JorjBauer/profile-emulator/fpga/hw-r2/profile-drive/placement-r2.png

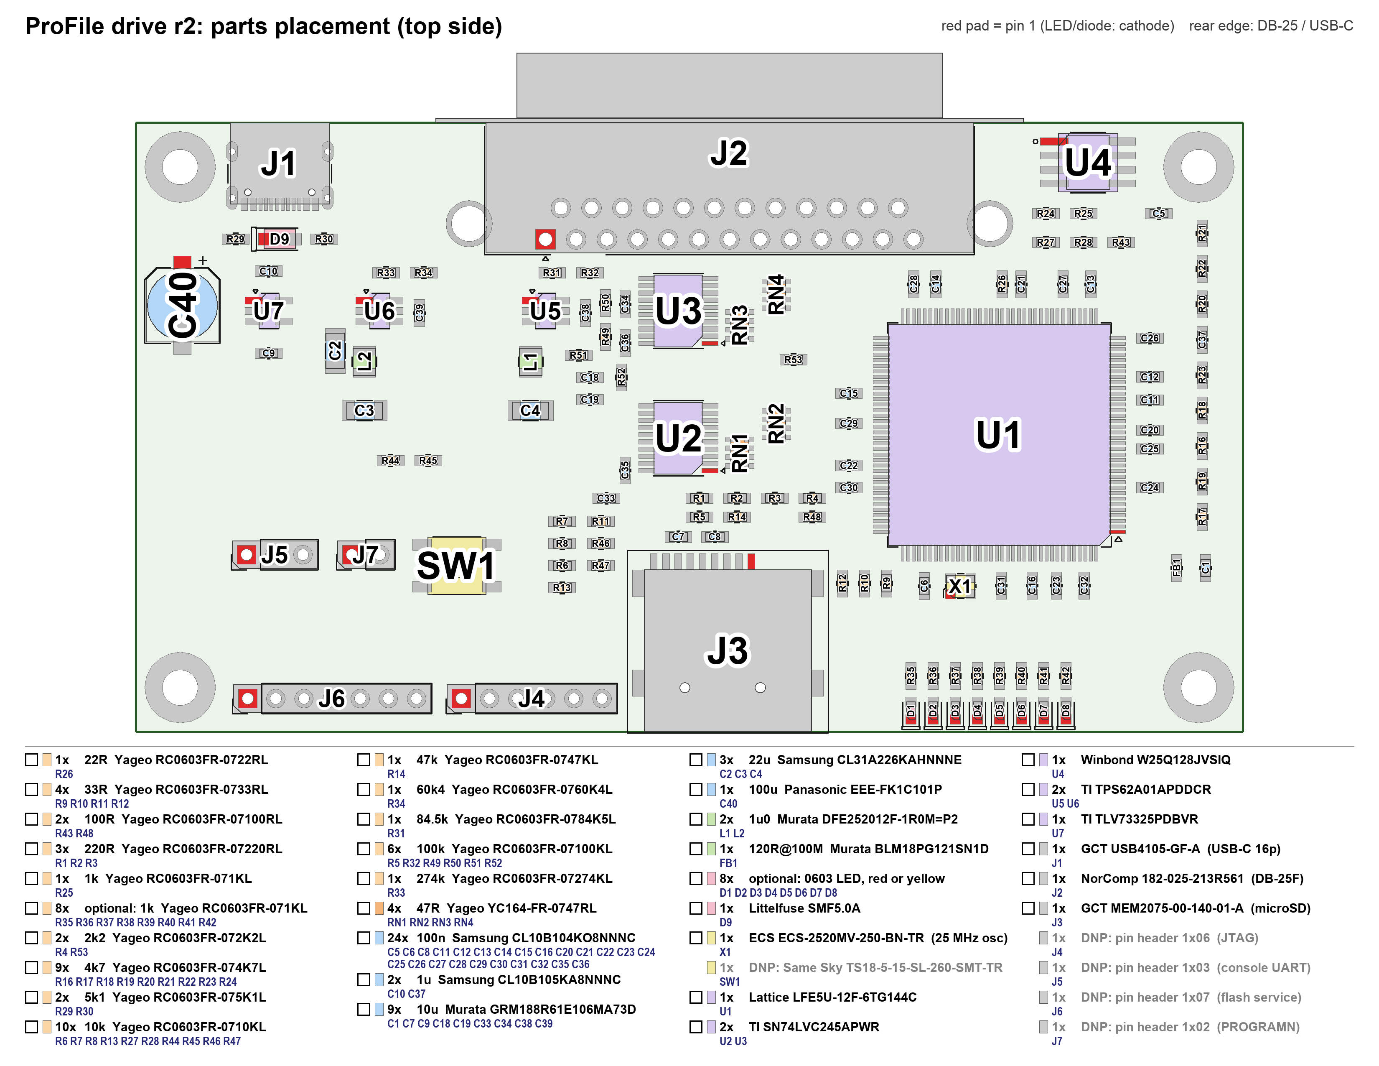
fpga/hw-r2/profile-drive/placement-r2.png
