JorjBauer/profile-emulator/fpga/hw-r2/profile-drive/profile-drive-r2-bom-jlcpcb.csv

Comment | Designator | Footprint | Manufacturer Part | LCSC Part #
10u | C1,C7,C9,C18,C19,C33,C34,C38,C39 | C_0603_1608Metric | Murata GRM188R61E106MA73D | C91606
22u | C2,C3,C4 | C_1206_3216Metric | Samsung CL31A226KAHNNNE | C12891
100n | C5,C6,C8,C11,C12,C13,C14,C15,C16,C20,C21,C22,C23,C24,C25,C26,C27,C28,C29,C30,C31,C32,C35,C36 | C_0603_1608Metric | Samsung CL10B104KO8NNNC | C66501
1u | C10,C37 | C_0603_1608Metric | Samsung CL10B105KA8NNNC | C29936
100u | C40 | CP_Elec_6.3x5.8 | Panasonic EEE-FK1C101P | C128532
LED red 0603 | D1,D2,D3,D4,D5,D6,D7,D8 | LED_0603_1608Metric | Hubei KENTO KT-0603R | C2286
SMF5.0A | D9 | D_SOD-123F | Littelfuse SMF5.0A | C151296
120R@100M | FB1 | L_0603_1608Metric | Murata BLM18PG121SN1D | C14709
USB-C 16p | J1 | USB_C_Receptacle_GCT_USB4105-xx-A_16P_TopMnt_Horizontal | GCT USB4105-GF-A | C3020560
NorComp 182-025-213R561 | J2 | DSUB-25_Female_Horizontal_NorComp_182-025-213R561 | NorComp 182-025-213R561 | C17257261
microSD MEM2075 | J3 | microSD_GCT_MEM2075 | GCT MEM2075-00-140-01-A | C3029735
1u0 | L1,L2 | L_Murata_DFE252012F | Murata DFE252012F-1R0M=P2 | C435392
220R | R1,R2,R3 | R_0603_1608Metric | Yageo RC0603FR-07220RL | C107696
2k2 | R4,R53 | R_0603_1608Metric | Yageo RC0603FR-072K2L | C114662
100k | R5,R32,R49,R50,R51,R52 | R_0603_1608Metric | Yageo RC0603FR-07100KL | C14675
10k | R6,R7,R8,R13,R27,R28,R44,R45,R46,R47 | R_0603_1608Metric | Yageo RC0603FR-0710KL | C98220
33R | R9,R10,R11,R12 | R_0603_1608Metric | Yageo RC0603FR-0733RL | C108661
47k | R14 | R_0603_1608Metric | Yageo RC0603FR-0747KL | C105579
4k7 | R16,R17,R18,R19,R20,R21,R22,R23,R24 | R_0603_1608Metric | Yageo RC0603FR-074K7L | C99782
1k | R25,R35,R36,R37,R38,R39,R40,R41,R42 | R_0603_1608Metric | Yageo RC0603FR-071KL | C22548
22R | R26 | R_0603_1608Metric | Yageo RC0603FR-0722RL | C107701
5k1 | R29,R30 | R_0603_1608Metric | Yageo RC0603FR-075K1L | C105580
84.5k | R31 | R_0603_1608Metric | Yageo RC0603FR-0784K5L | C326920
274k | R33 | R_0603_1608Metric | Yageo RC0603FR-07274KL | C482818
60k4 | R34 | R_0603_1608Metric | Yageo RC0603FR-0760K4L | C165742
100R | R43,R48 | R_0603_1608Metric | Yageo RC0603FR-07100RL | C105588
47R | RN1,RN2,RN3,RN4 | R_Array_Convex_4x0603_Yageo_YC164 | Yageo YC164-FR-0747RL | C606217
LFE5U-12F-6TG144C | U1 | TQFP-144_20x20mm_P0.5mm | Lattice LFE5U-12F-6TG144C | C19979181
74LVC245A | U2,U3 | TSSOP-20_4.4x6.5mm_P0.65mm | TI SN74LVC245APWR | C7848
W25Q128JVSIQ | U4 | SOIC-8_Dual_150-208mil_P1.27mm | Winbond W25Q128JVSIQ | C97521
TPS62A01A | U5,U6 | SOT-23-6_Handsoldering | TI TPS62A01APDDCR | C41730179
TLV73325PDBV 2V5 | U7 | SOT-23-5_HandSoldering | TI TLV73325PDBVR | C882825
25MHz XO 2520 3V3 | X1 | Oscillator_SMD_ECS_2520MV-xxx-xx-4Pin_2.5x2.0mm | ECS ECS-2520MV-250-BN-TR | C405463
