JorjBauer/profile-emulator/fpga/hw-r2/enclosure/base.stl

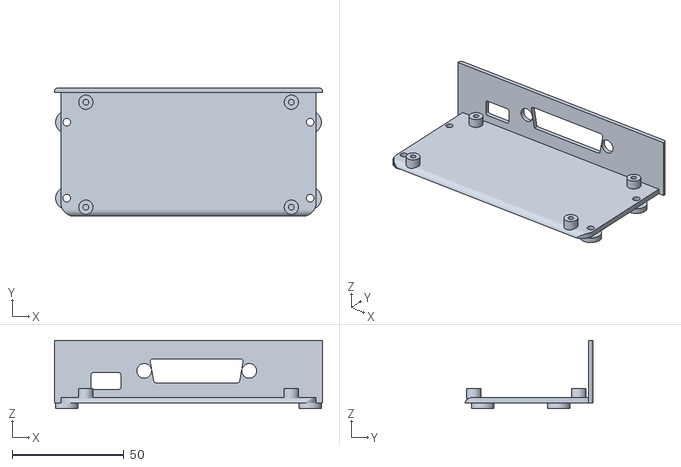
[picture p4: CAD file, 2026-10-11]
fpga/hw-r2/enclosure/base.stl
120.0 x 57.4 x 30.5
