JorjBauer/profile-emulator/fpga/hw-r2/enclosure/cover.stl

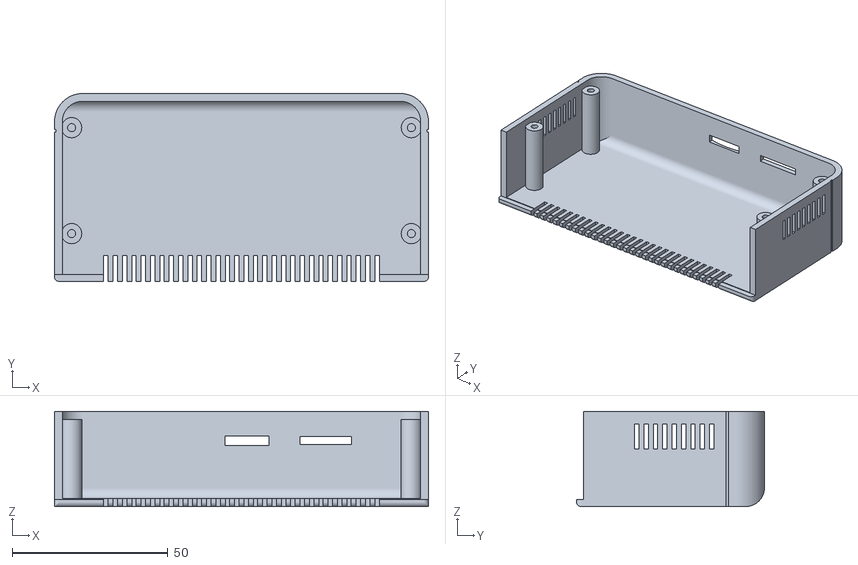
[picture p5: CAD file, 2026-10-10]
fpga/hw-r2/enclosure/cover.stl
120.0 x 60.3 x 30.5
