JorjBauer/profile-emulator/fpga/hw-r2/profile-drive/assembly-r2.pdf

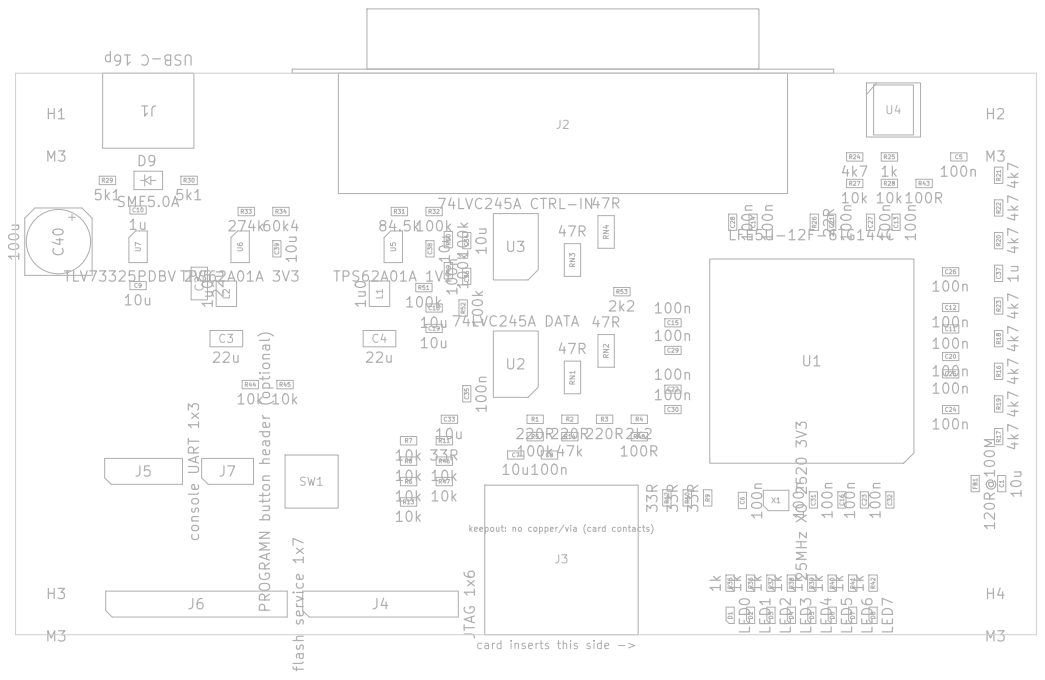
[picture p6: page 1]

keepout: no copper/via (card contacts) J3 10u

File: profile-drive.kicad_pcb
Title: ProFile drive replacement: LFE5U-12F TQFP144, standalone

Size: A4 | Rev: r2
KiCad E.D.A. 10.0.4 | Id: 1/1
