JorjBauer/profile-emulator/fpga/hw-r2/profile-drive/profile-drive.kicad_pcb

## KiCad design fpga/hw-r2/profile-drive/profile-drive.kicad_pcb (2026-10-25)

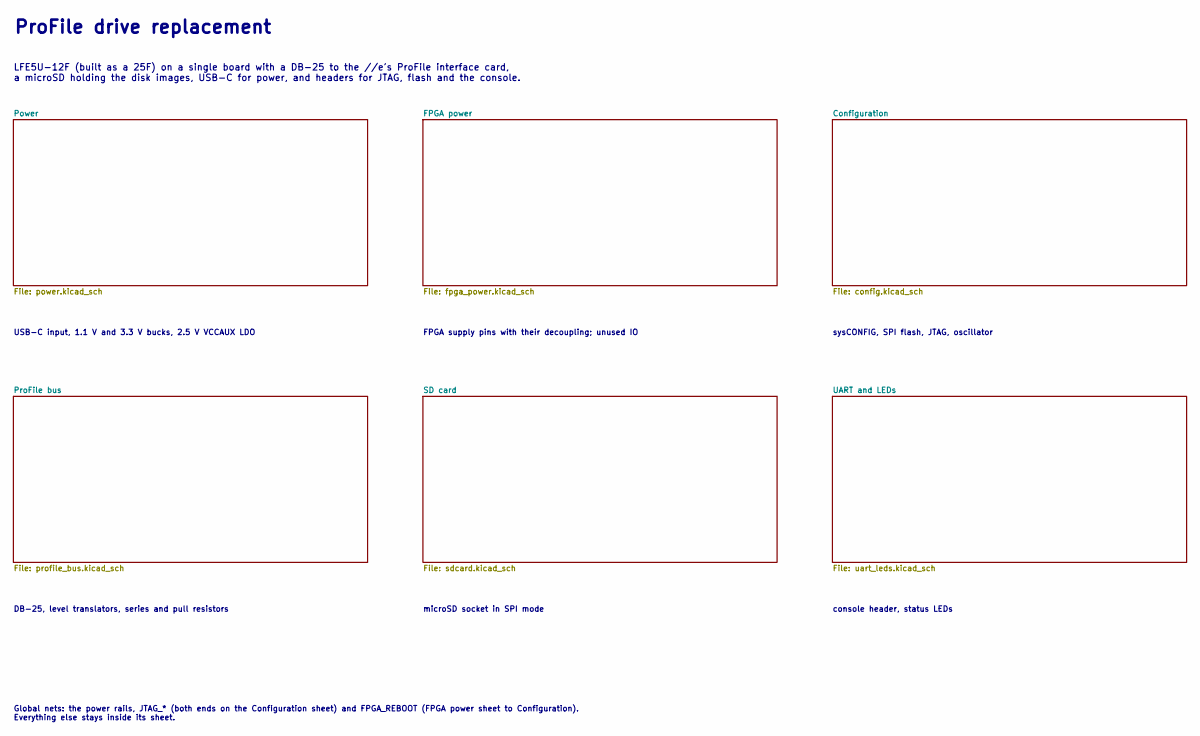
[picture p7: schematic profile-drive.kicad_sch, ProFile drive replacement: LFE5U-12F TQFP144, standalone]

Notes on the sheet:
ProFile drive replacement
LFE5U-12F (built as a 25F) on a single board with a DB-25 to the //e's ProFile interface card, a microSD holding the disk images, USB-C for power, and headers for JTAG, flash and the console.
USB-C input, 1.1 V and 3.3 V bucks, 2.5 V VCCAUX LDO
FPGA supply pins with their decoupling; unused IO
sysCONFIG, SPI flash, JTAG, oscillator
DB-25, level translators, series and pull resistors
microSD socket in SPI mode
console header, status LEDs
Global nets: the power rails, JTAG_* (both ends on the Configuration sheet) and FPGA_REBOOT (FPGA power sheet to Configuration). Everything else stays inside its sheet.

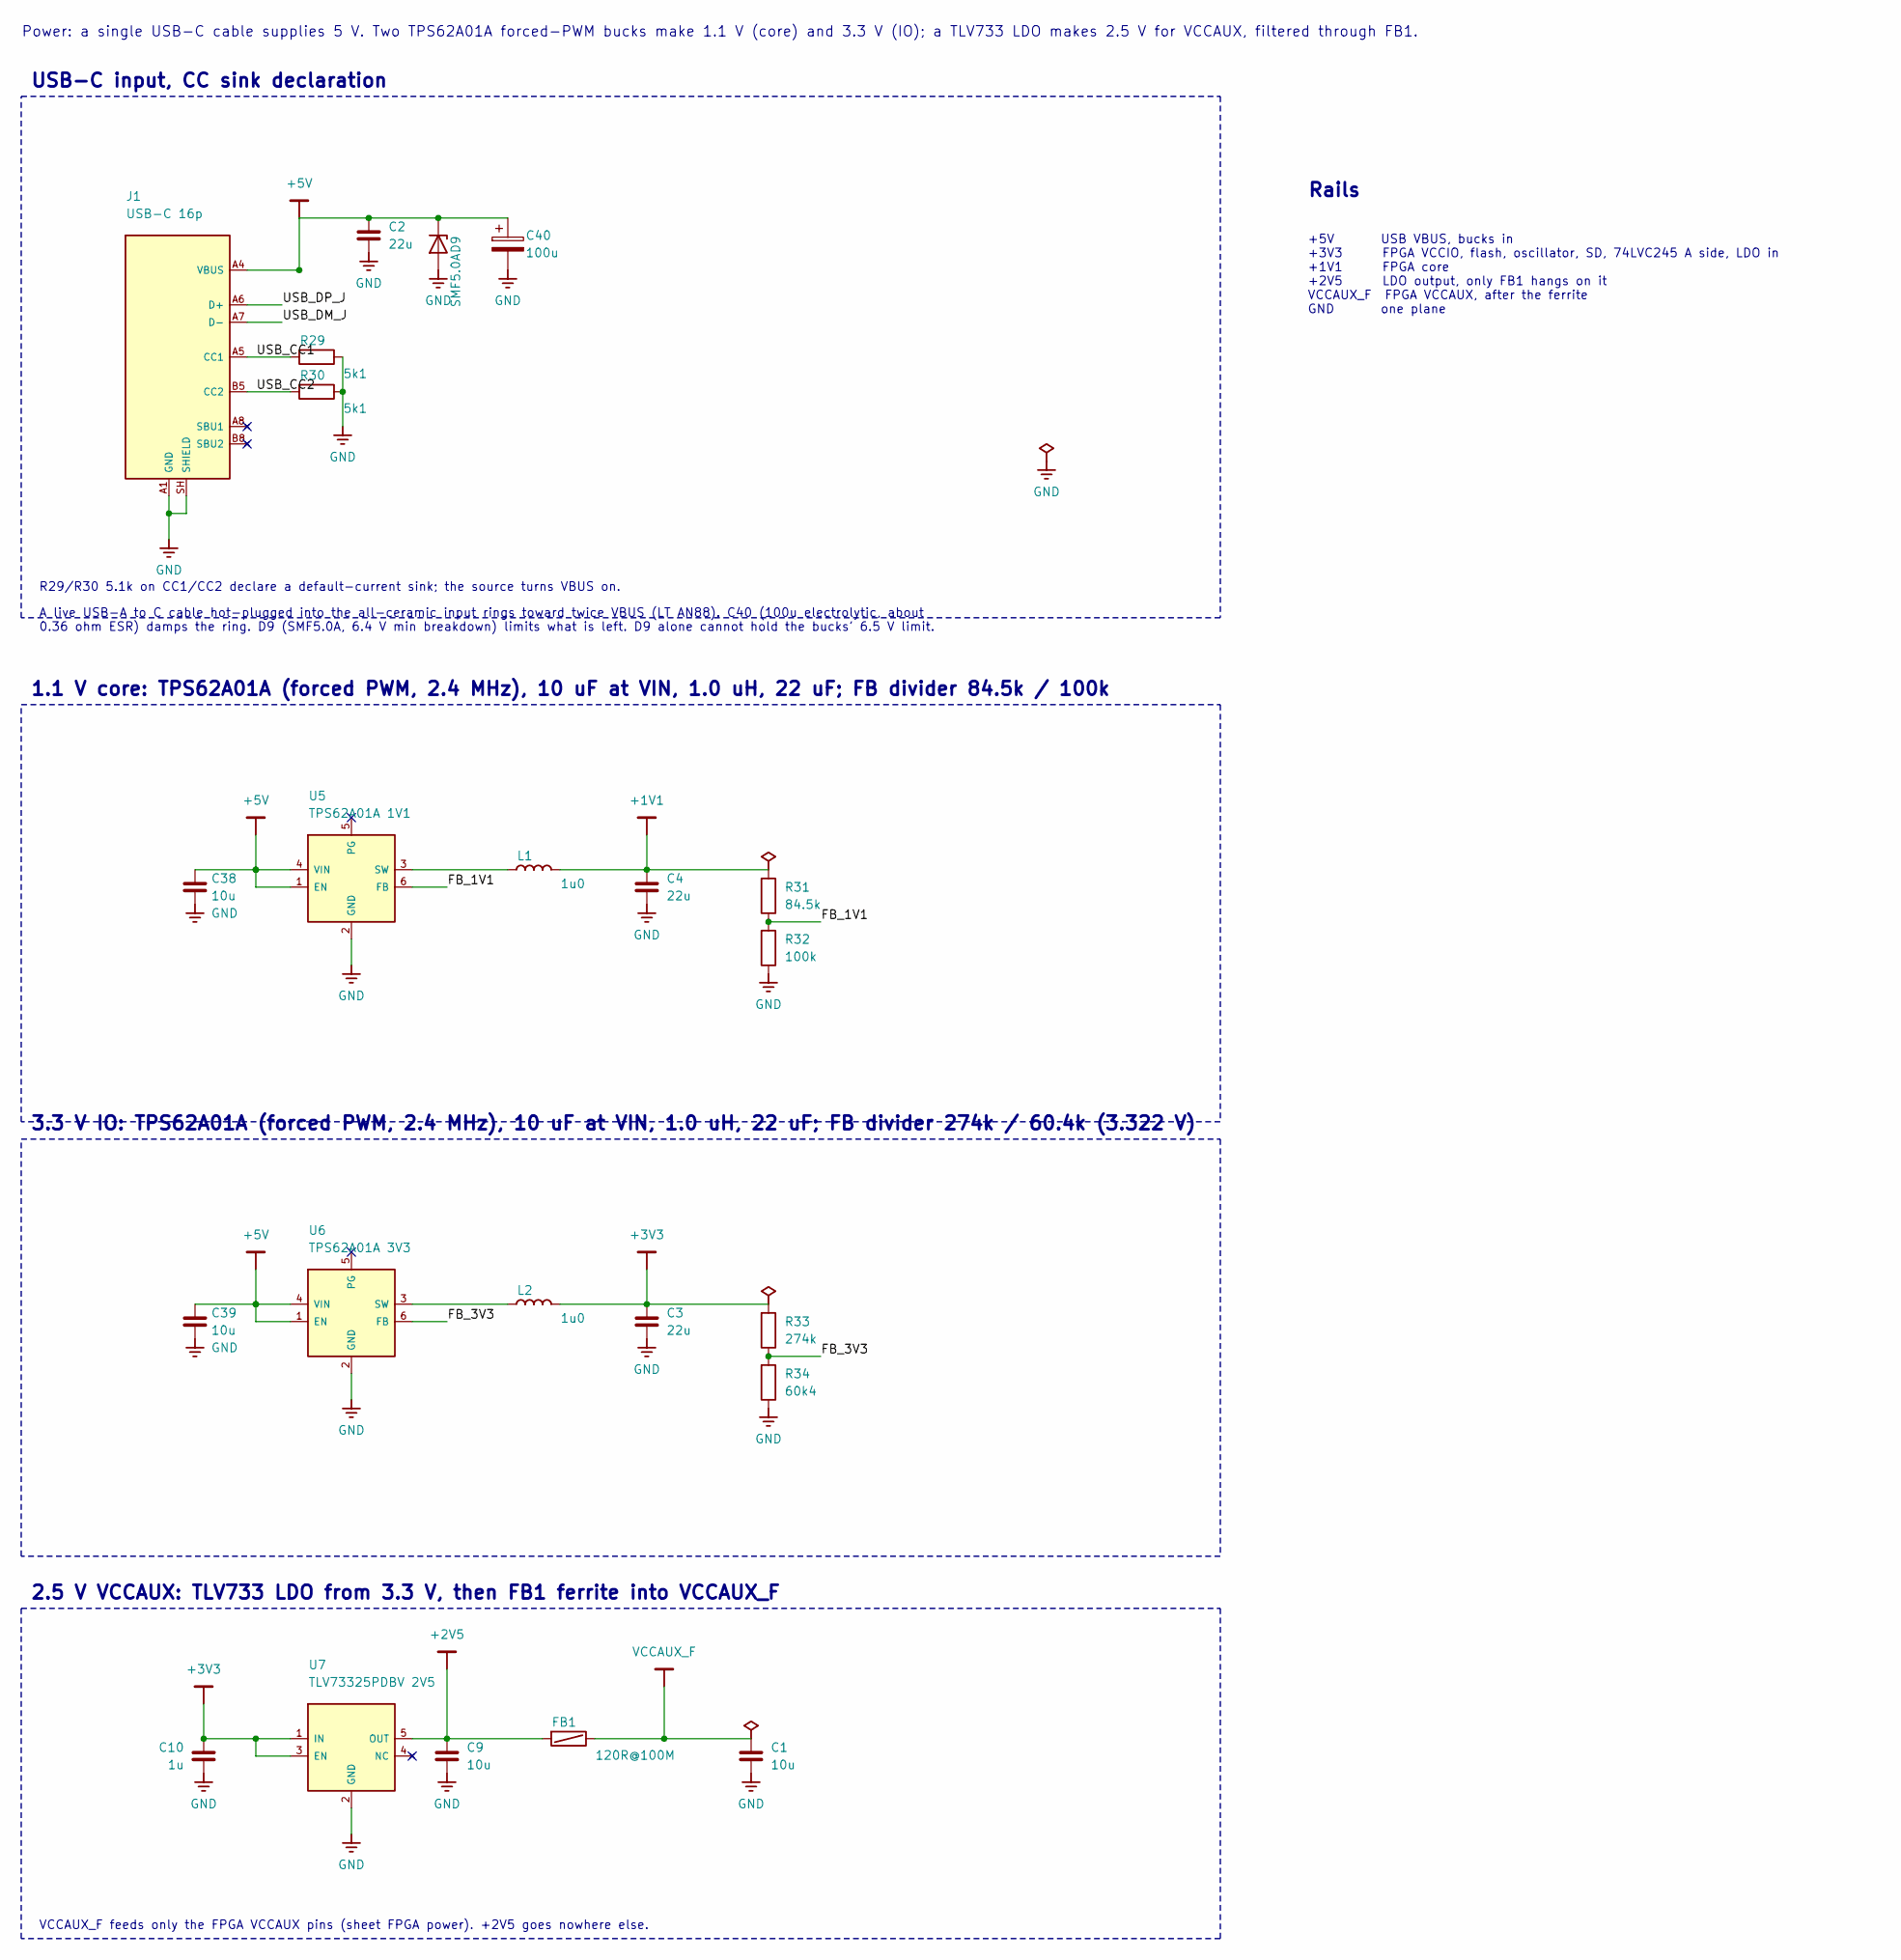
[picture p8: schematic power.kicad_sch]

Parts:
C1, C9, C38, C39: 10u; C_0603_1608Metric; MPN Murata GRM188R61E106MA73D; LCSC C91606
C2, C3, C4: 22u; C_1206_3216Metric; MPN Samsung CL31A226KAHNNNE; LCSC C12891
C10: 1u; C_0603_1608Metric; MPN Samsung CL10B105KA8NNNC; LCSC C29936
C40: 100u; CP_Elec_6.3x5.8; MPN Panasonic EEE-FK1C101P; LCSC C128532
D9: SMF5.0A; D_SOD-123F; MPN Littelfuse SMF5.0A; LCSC C151296
FB1: 120R@100M; L_0603_1608Metric; MPN Murata BLM18PG121SN1D; LCSC C14709
J1: USB-C 16p; USB_C_Receptacle_GCT_USB4105-xx-A_16P_TopMnt_Horizontal; MPN GCT USB4105-GF-A; LCSC C3020560
L1, L2: 1u0; L_Murata_DFE252012F; MPN Murata DFE252012F-1R0M=P2; LCSC C435392
R29, R30: 5k1; R_0603_1608Metric; MPN Yageo RC0603FR-075K1L; LCSC C105580
R31: 84.5k; R_0603_1608Metric; MPN Yageo RC0603FR-0784K5L; LCSC C326920
R32: 100k; R_0603_1608Metric; MPN Yageo RC0603FR-07100KL; LCSC C14675
R33: 274k; R_0603_1608Metric; MPN Yageo RC0603FR-07274KL; LCSC C482818
R34: 60k4; R_0603_1608Metric; MPN Yageo RC0603FR-0760K4L; LCSC C165742
U5: TPS62A01A 1V1; SOT-23-6_Handsoldering; MPN TI TPS62A01APDDCR; LCSC C41730179
U6: TPS62A01A 3V3; SOT-23-6_Handsoldering; MPN TI TPS62A01APDDCR; LCSC C41730179
U7: TLV73325PDBV 2V5; SOT-23-5_HandSoldering; MPN TI TLV73325PDBVR; LCSC C882825

Connections:
+1V1: C4.1, L1.2, R31.1; also elsewhere on the board
+2V5: C9.1, FB1.1, U7.5 (OUT)
+5V: C2.1, C38.1, C39.1, C40.1, D9.1 (K), J1.A4 (VBUS), J1.A9 (VBUS), J1.B4 (VBUS), J1.B9 (VBUS), U5.1 (EN), U5.4 (VIN), U6.1 (EN), U6.4 (VIN)
/Power/FB_1V1: R31.2, R32.1, U5.6 (FB)
/Power/FB_3V3: R33.2, R34.1, U6.6 (FB)
/Power/USB_CC1: J1.A5 (CC1), R29.1
/Power/USB_CC2: J1.B5 (CC2), R30.1
/Power/USB_DM_J: J1.A7 (D-), J1.B7 (D-)
/Power/USB_DP_J: J1.A6 (D+), J1.B6 (D+)
unnamed: L1.1, U5.3 (SW)
unnamed: L2.1, U6.3 (SW)
VCCAUX_F: C1.1, FB1.2; also elsewhere on the board

Notes on the sheet:
Power: a single USB-C cable supplies 5 V. Two TPS62A01A forced-PWM bucks make 1.1 V (core) and 3.3 V (IO); a TLV733 LDO makes 2.5 V for VCCAUX, filtered through FB1.
USB-C input, CC sink declaration
R29/R30 5.1k on CC1/CC2 declare a default-current sink; the source turns VBUS on.
1.1 V core: TPS62A01A (forced PWM, 2.4 MHz), 10 uF at VIN, 1.0 uH, 22 uF; FB divider 84.5k / 100k
3.3 V IO: TPS62A01A (forced PWM, 2.4 MHz), 10 uF at VIN, 1.0 uH, 22 uF; FB divider 274k / 60.4k (3.322 V)
2.5 V VCCAUX: TLV733 LDO from 3.3 V, then FB1 ferrite into VCCAUX_F
VCCAUX_F feeds only the FPGA VCCAUX pins (sheet FPGA power). +2V5 goes nowhere else.
Rails
+5V USB VBUS, bucks in +3V3 FPGA VCCIO, flash, oscillator, SD, 74LVC245 A side, LDO in +1V1 FPGA core +2V5 LDO output, only FB1 hangs on it VCCAUX_F FPGA VCCAUX, after the ferrite GND one plane
A live USB-A to C cable hot-plugged into the all-ceramic input rings toward twice VBUS (LT AN88). C40 (100u electrolytic, about 0.36 ohm ESR) damps the ring. D9 (SMF5.0A, 6.4 V min breakdown) limits what is left. D9 alone cannot hold the bucks' 6.5 V limit.

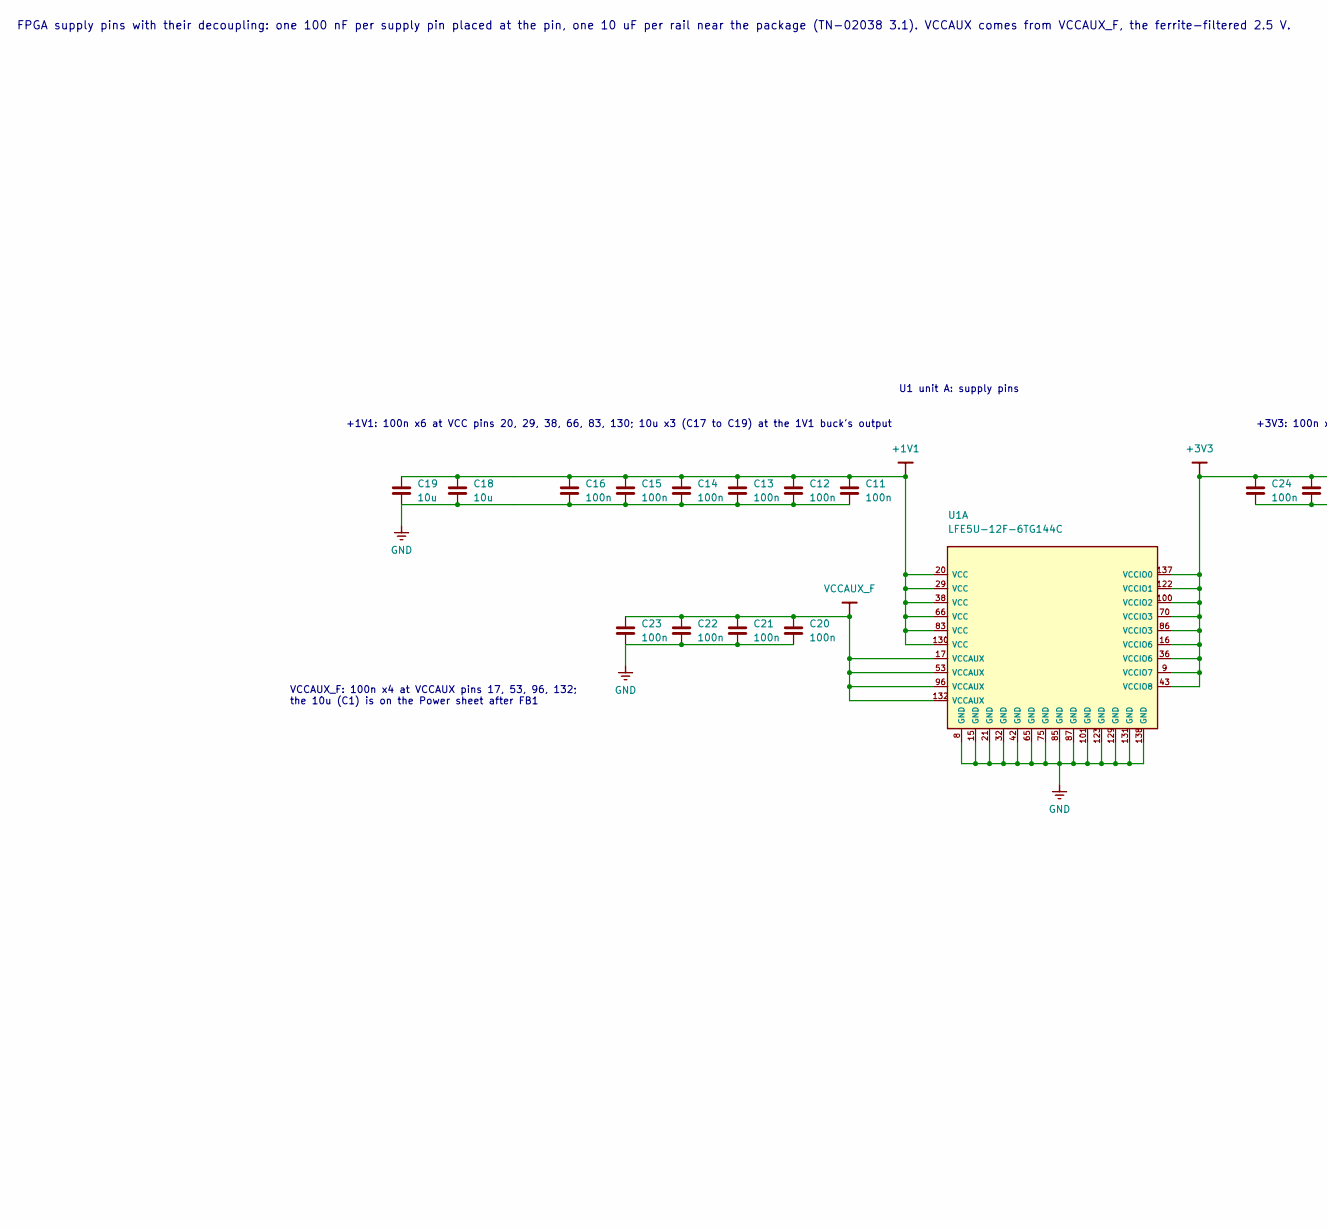
[picture p9: schematic fpga_power.kicad_sch, FPGA power, part in row 1, column 1]

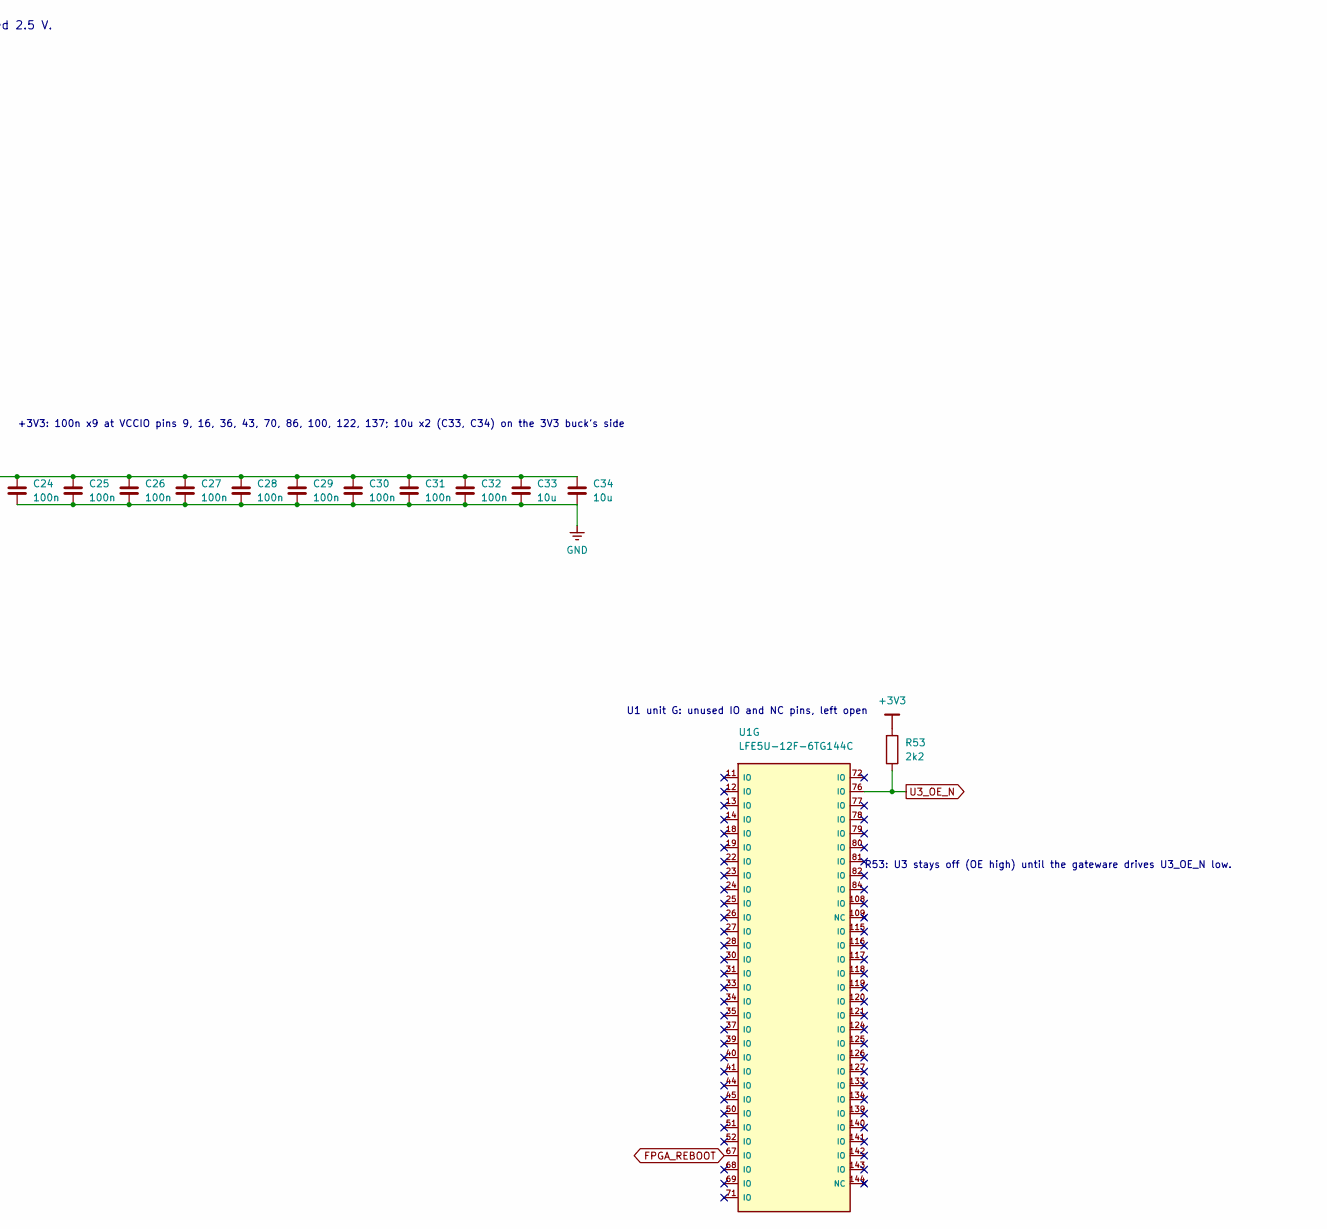
[picture p10: schematic fpga_power.kicad_sch, FPGA power, part in row 1, column 2]

Parts:
C11, C12, C13, C14, C15, C16, C20, C21, C22, C23, C24, C25, C26, C27, C28, C29, C30, C31, C32: 100n; C_0603_1608Metric; MPN Samsung CL10B104KO8NNNC; LCSC C66501
C18, C19, C33, C34: 10u; C_0603_1608Metric; MPN Murata GRM188R61E106MA73D; LCSC C91606
R53: 2k2; R_0603_1608Metric; MPN Yageo RC0603FR-072K2L; LCSC C114662
U1: LFE5U-12F-6TG144C; TQFP-144_20x20mm_P0.5mm; MPN Lattice LFE5U-12F-6TG144C; LCSC C19979181

Connections:
+1V1: C11.1, C12.1, C13.1, C14.1, C15.1, C16.1, C18.1, C19.1, U1.20 (VCC), U1.29 (VCC), U1.38 (VCC), U1.66 (VCC), U1.83 (VCC), U1.130 (VCC); also elsewhere on the board
FPGA_REBOOT: U1.67 (IO); also elsewhere on the board
U3_OE_N: R53.2, U1.76 (IO); also elsewhere on the board
VCCAUX_F: C20.1, C21.1, C22.1, C23.1, U1.17 (VCCAUX), U1.53 (VCCAUX), U1.96 (VCCAUX), U1.132 (VCCAUX); also elsewhere on the board

Notes on the sheet:
FPGA supply pins with their decoupling: one 100 nF per supply pin placed at the pin, one 10 uF per rail near the package (TN-02038 3.1). VCCAUX comes from VCCAUX_F, the ferrite-filtered 2.5 V.
U1 unit A: supply pins
+1V1: 100n x6 at VCC pins 20, 29, 38, 66, 83, 130; 10u x3 (C17 to C19) at the 1V1 buck's output
VCCAUX_F: 100n x4 at VCCAUX pins 17, 53, 96, 132; the 10u (C1) is on the Power sheet after FB1
+3V3: 100n x9 at VCCIO pins 9, 16, 36, 43, 70, 86, 100, 122, 137; 10u x2 (C33, C34) on the 3V3 buck's side
U1 unit G: unused IO and NC pins, left open
R53: U3 stays off (OE high) until the gateware drives U3_OE_N low.

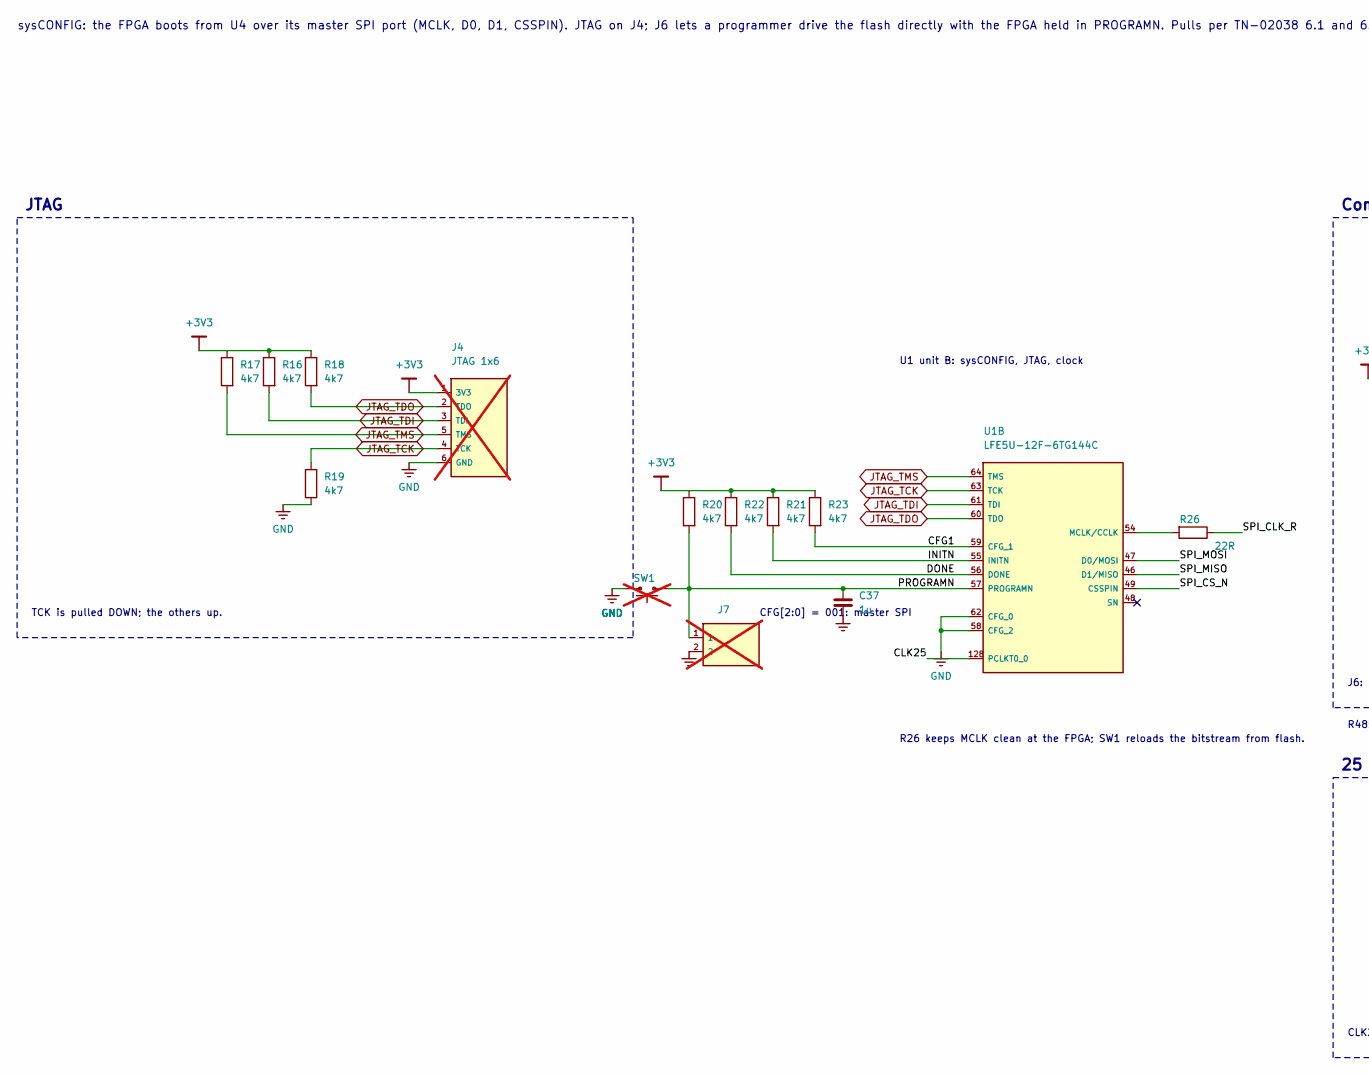
[picture p11: schematic config.kicad_sch, Configuration, part in row 1, column 1]

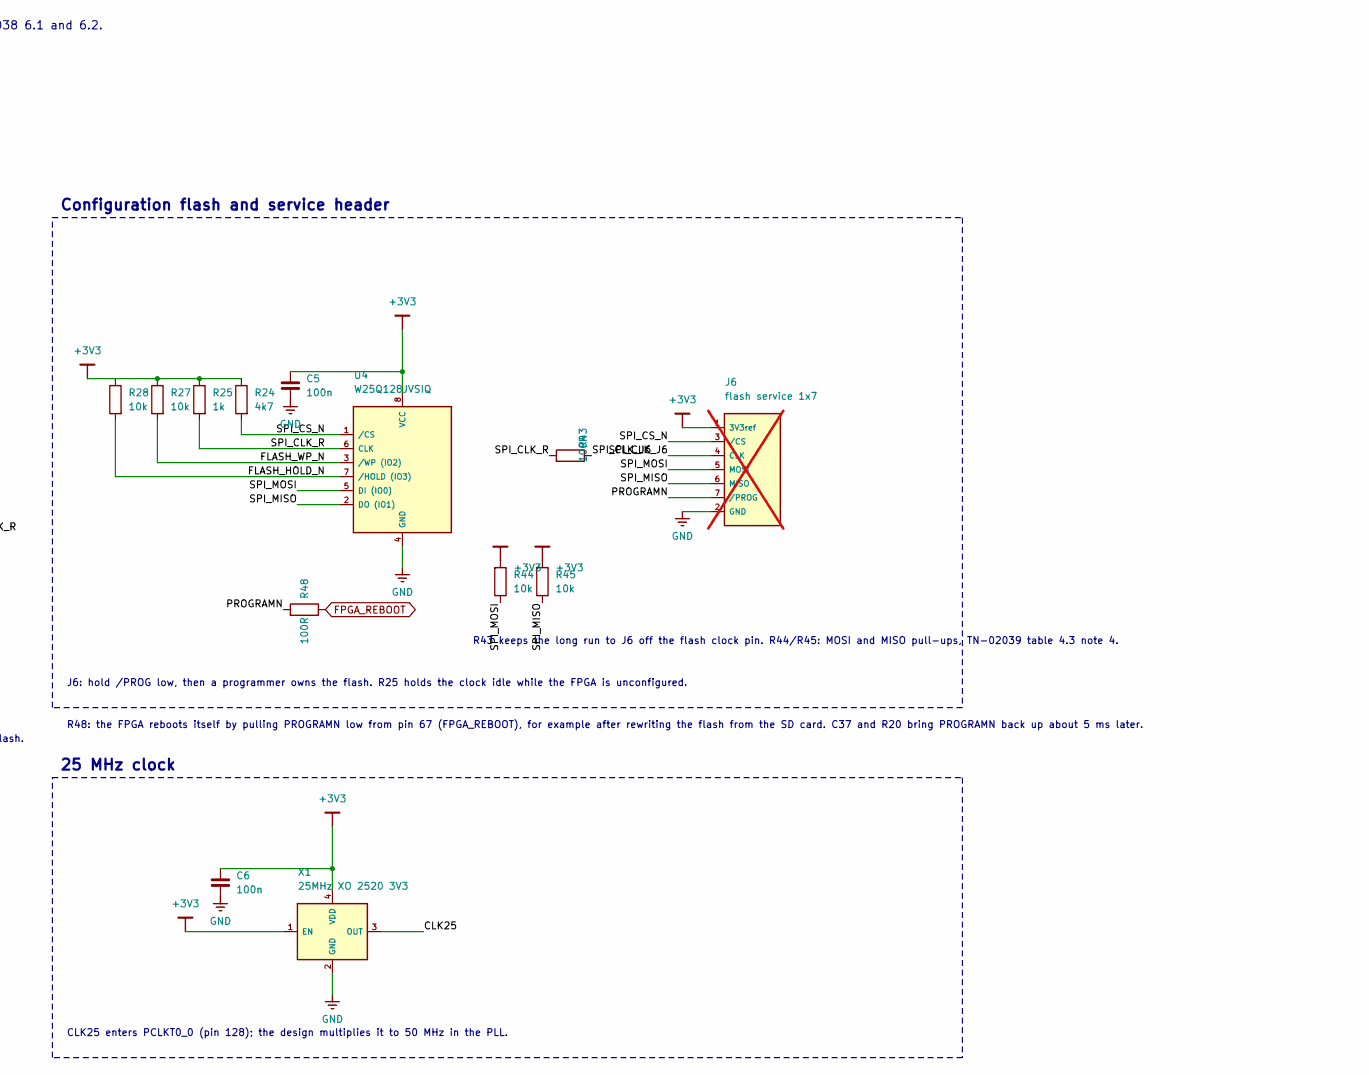
[picture p12: schematic config.kicad_sch, Configuration, part in row 1, column 2]

Parts:
C5, C6: 100n; C_0603_1608Metric; MPN Samsung CL10B104KO8NNNC; LCSC C66501
C37: 1u; C_0603_1608Metric; MPN Samsung CL10B105KA8NNNC; LCSC C29936
J4: JTAG 1x6; PinHeader_1x06_P2.54mm_Vertical; LCSC C37208; not fitted
J6: flash service 1x7; PinHeader_1x07_P2.54mm_Vertical; not fitted
J7: PROGRAMN button header (optional); PinHeader_1x02_P2.54mm_Vertical; not fitted
R16, R17, R18, R19, R20, R21, R22, R23, R24: 4k7; R_0603_1608Metric; MPN Yageo RC0603FR-074K7L; LCSC C99782
R25: 1k; R_0603_1608Metric; MPN Yageo RC0603FR-071KL; LCSC C22548
R26: 22R; R_0603_1608Metric; MPN Yageo RC0603FR-0722RL; LCSC C107701
R27, R28, R44, R45: 10k; R_0603_1608Metric; MPN Yageo RC0603FR-0710KL; LCSC C98220
R43, R48: 100R; R_0603_1608Metric; MPN Yageo RC0603FR-07100RL; LCSC C105588
SW1: PROGRAMN button; SW_Push_SameSky_TS18-5; MPN Same Sky TS18-5-15-SL-260-SMT-TR; LCSC C7074292; not fitted
U1: LFE5U-12F-6TG144C; TQFP-144_20x20mm_P0.5mm; MPN Lattice LFE5U-12F-6TG144C; LCSC C19979181
U4: W25Q128JVSIQ; SOIC-8_Dual_150-208mil_P1.27mm; MPN Winbond W25Q128JVSIQ; LCSC C97521
X1: 25MHz XO 2520 3V3; Oscillator_SMD_ECS_2520MV-xxx-xx-4Pin_2.5x2.0mm; MPN ECS ECS-2520MV-250-BN-TR; LCSC C405463

Connections:
/Configuration/CFG1: R23.1, U1.59 (CFG_1)
/Configuration/CLK25: U1.128 (PCLKT0_0), X1.3 (OUT)
/Configuration/DONE: R22.1, U1.56 (DONE)
/Configuration/FLASH_HOLD_N: R28.1, U4.7 (/HOLD (IO3))
/Configuration/FLASH_WP_N: R27.1, U4.3 (/WP (IO2))
/Configuration/INITN: R21.1, U1.55 (INITN)
/Configuration/PROGRAMN: C37.1, J6.7 (/PROG), J7.1, R20.1, R48.1, SW1.1, U1.57 (PROGRAMN)
/Configuration/SPI_CLK_J6: J6.4 (CLK), R43.2
/Configuration/SPI_CLK_R: R25.1, R26.2, R43.1, U4.6 (CLK)
/Configuration/SPI_CS_N: J6.3 (/CS), R24.1, U1.49 (CSSPIN), U4.1 (/CS)
/Configuration/SPI_MISO: J6.6 (MISO), R45.2, U1.46 (D1/MISO), U4.2 (DO (IO1))
/Configuration/SPI_MOSI: J6.5 (MOSI), R44.2, U1.47 (D0/MOSI), U4.5 (DI (IO0))
FPGA_REBOOT: R48.2; also elsewhere on the board
JTAG_TCK: J4.4 (TCK), R19.1, U1.63 (TCK)
JTAG_TDI: J4.3 (TDI), R16.1, U1.61 (TDI)
JTAG_TDO: J4.2 (TDO), R18.1, U1.60 (TDO)
JTAG_TMS: J4.5 (TMS), R17.1, U1.64 (TMS)
unnamed: R26.1, U1.54 (MCLK/CCLK)

Notes on the sheet:
sysCONFIG: the FPGA boots from U4 over its master SPI port (MCLK, D0, D1, CSSPIN). JTAG on J4; J6 lets a programmer drive the flash directly with the FPGA held in PROGRAMN. Pulls per TN-02038 6.1 and 6.2.
U1 unit B: sysCONFIG, JTAG, clock
CFG[2:0] = 001: master SPI
R26 keeps MCLK clean at the FPGA; SW1 reloads the bitstream from flash.
JTAG
TCK is pulled DOWN; the others up.
Configuration flash and service header
J6: hold /PROG low, then a programmer owns the flash. R25 holds the clock idle while the FPGA is unconfigured.
25 MHz clock
CLK25 enters PCLKT0_0 (pin 128); the design multiplies it to 50 MHz in the PLL.
R43 keeps the long run to J6 off the flash clock pin. R44/R45: MOSI and MISO pull-ups, TN-02039 table 4.3 note 4.
R48: the FPGA reboots itself by pulling PROGRAMN low from pin 67 (FPGA_REBOOT), for example after rewriting the flash from the SD card. C37 and R20 bring PROGRAMN back up about 5 ms later.

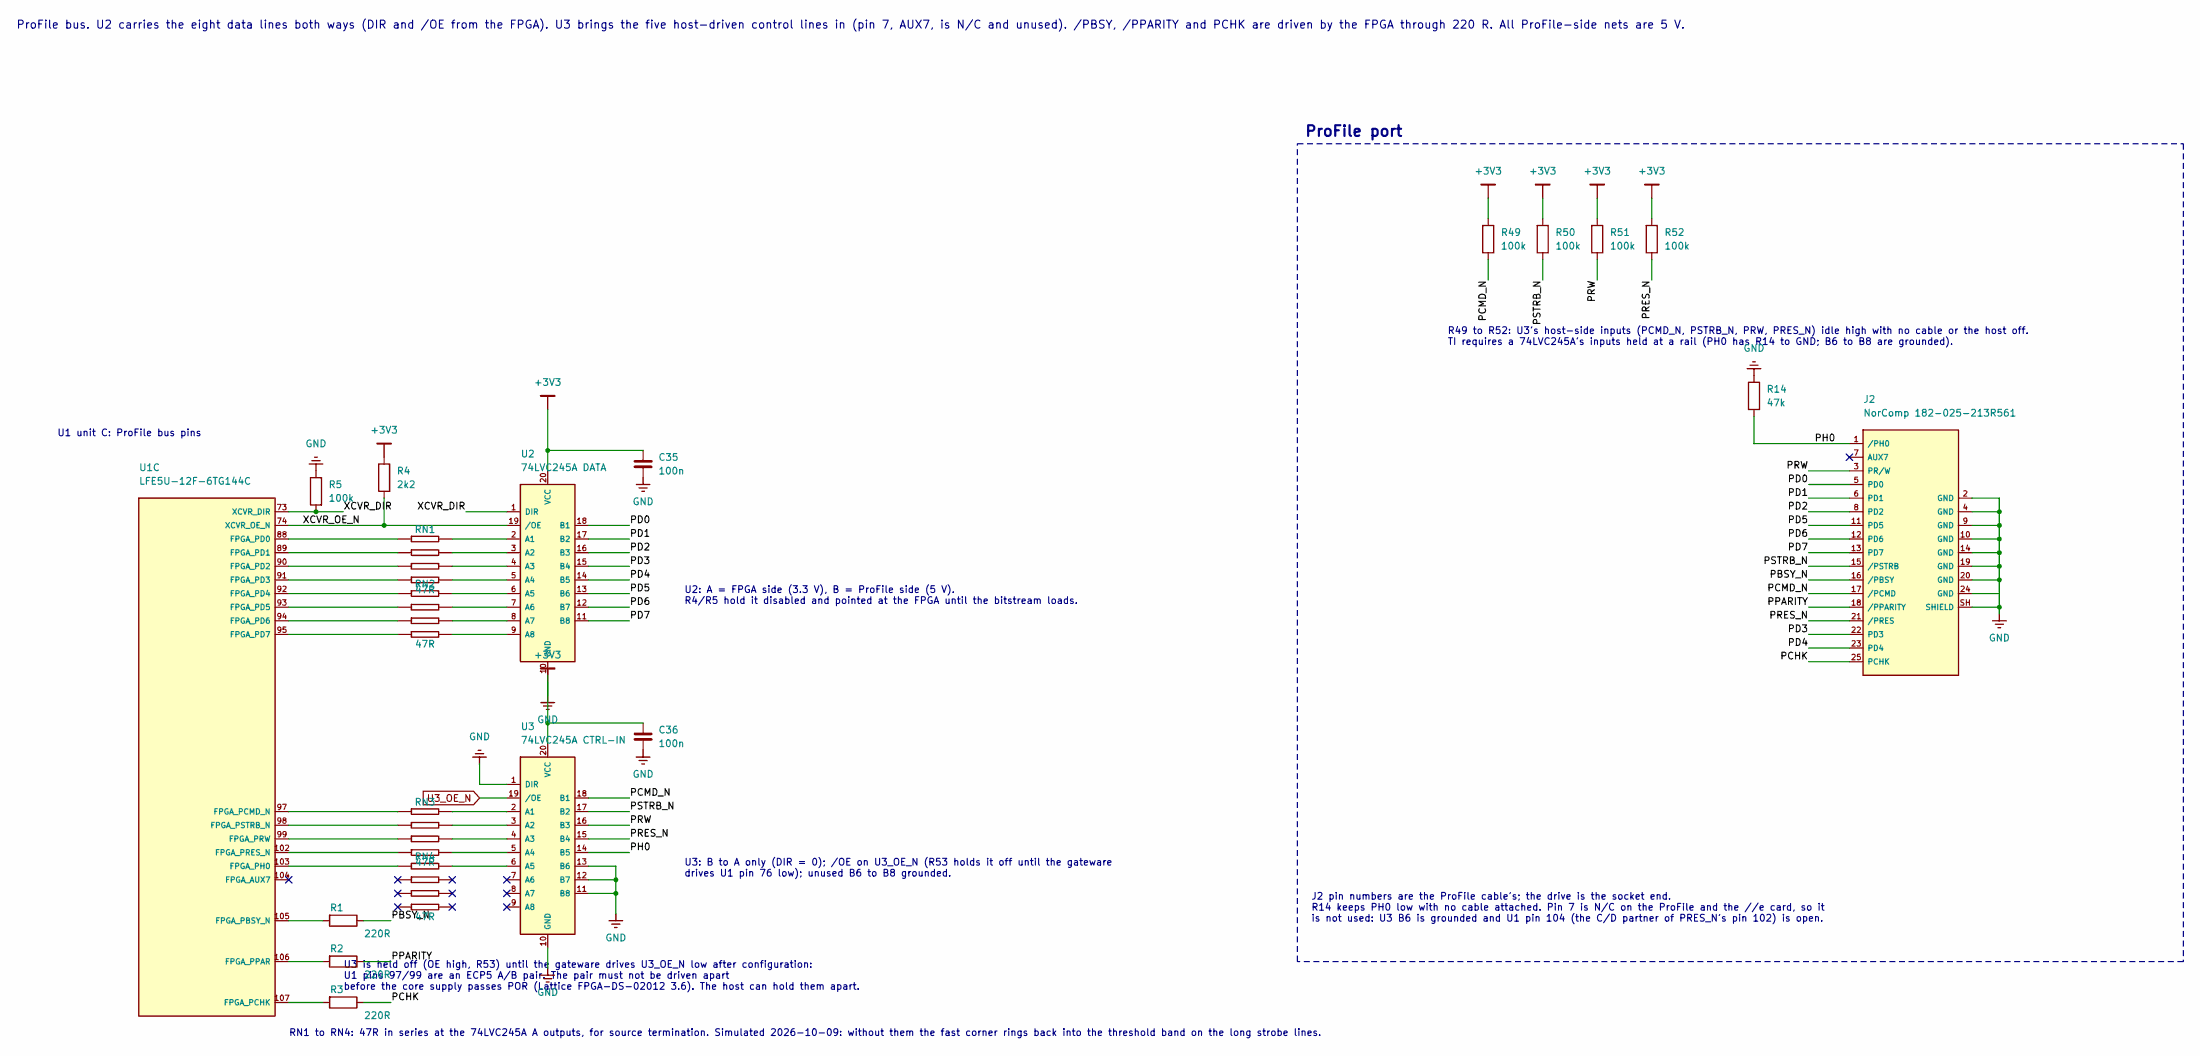
[picture p13: schematic profile_bus.kicad_sch, ProFile bus]

Parts:
C35, C36: 100n; C_0603_1608Metric; MPN Samsung CL10B104KO8NNNC; LCSC C66501
J2: NorComp 182-025-213R561; DSUB-25_Female_Horizontal_NorComp_182-025-213R561; MPN NorComp 182-025-213R561; LCSC C17257261
R1, R2, R3: 220R; R_0603_1608Metric; MPN Yageo RC0603FR-07220RL; LCSC C107696
R4: 2k2; R_0603_1608Metric; MPN Yageo RC0603FR-072K2L; LCSC C114662
R5, R49, R50, R51, R52: 100k; R_0603_1608Metric; MPN Yageo RC0603FR-07100KL; LCSC C14675
R14: 47k; R_0603_1608Metric; MPN Yageo RC0603FR-0747KL; LCSC C105579
RN1, RN2, RN3, RN4: 47R; R_Array_Convex_4x0603_Yageo_YC164; MPN Yageo YC164-FR-0747RL; LCSC C606217
U1: LFE5U-12F-6TG144C; TQFP-144_20x20mm_P0.5mm; MPN Lattice LFE5U-12F-6TG144C; LCSC C19979181
U2: 74LVC245A DATA; TSSOP-20_4.4x6.5mm_P0.65mm; MPN TI SN74LVC245APWR; LCSC C7848
U3: 74LVC245A CTRL-IN; TSSOP-20_4.4x6.5mm_P0.65mm; MPN TI SN74LVC245APWR; LCSC C7848

Connections:
/ProFile bus/PBSY_N: J2.16 (/PBSY), R1.2
/ProFile bus/PCHK: J2.25 (PCHK), R3.2
/ProFile bus/PCMD_N: J2.17 (/PCMD), R49.2, U3.18 (B1)
/ProFile bus/PD0: J2.5 (PD0), U2.18 (B1)
/ProFile bus/PD1: J2.6 (PD1), U2.17 (B2)
/ProFile bus/PD2: J2.8 (PD2), U2.16 (B3)
/ProFile bus/PD3: J2.22 (PD3), U2.15 (B4)
/ProFile bus/PD4: J2.23 (PD4), U2.14 (B5)
/ProFile bus/PD5: J2.11 (PD5), U2.13 (B6)
/ProFile bus/PD6: J2.12 (PD6), U2.12 (B7)
/ProFile bus/PD7: J2.13 (PD7), U2.11 (B8)
/ProFile bus/PH0: J2.1 (/PH0), R14.1, U3.14 (B5)
/ProFile bus/PPARITY: J2.18 (/PPARITY), R2.2
/ProFile bus/PRES_N: J2.21 (/PRES), R52.2, U3.15 (B4)
/ProFile bus/PRW: J2.3 (PR/W), R51.2, U3.16 (B3)
/ProFile bus/PSTRB_N: J2.15 (/PSTRB), R50.2, U3.17 (B2)
/ProFile bus/XCVR_DIR: R5.1, U1.73 (XCVR_DIR), U2.1 (DIR)
/ProFile bus/XCVR_OE_N: R4.1, U1.74 (XCVR_OE_N), U2.19 (/OE)
unnamed: R1.1, U1.105 (FPGA_PBSY_N)
unnamed: R3.1, U1.107 (FPGA_PCHK)
unnamed: RN3.1, U1.97 (FPGA_PCMD_N)
unnamed: RN1.1, U1.88 (FPGA_PD0)
unnamed: RN1.2, U1.89 (FPGA_PD1)
unnamed: RN1.3, U1.90 (FPGA_PD2)
unnamed: RN1.4, U1.91 (FPGA_PD3)
unnamed: RN2.1, U1.92 (FPGA_PD4)
unnamed: RN2.2, U1.93 (FPGA_PD5)
unnamed: RN2.3, U1.94 (FPGA_PD6)
unnamed: RN2.4, U1.95 (FPGA_PD7)
unnamed: RN4.1, U1.103 (FPGA_PH0)
unnamed: R2.1, U1.106 (FPGA_PPAR)
unnamed: RN3.4, U1.102 (FPGA_PRES_N)
unnamed: RN3.3, U1.99 (FPGA_PRW)
unnamed: RN3.2, U1.98 (FPGA_PSTRB_N)
unnamed: RN1.8, U2.2 (A1)
unnamed: RN1.7, U2.3 (A2)
unnamed: RN1.6, U2.4 (A3)
unnamed: RN1.5, U2.5 (A4)
unnamed: RN2.8, U2.6 (A5)
unnamed: RN2.7, U2.7 (A6)
unnamed: RN2.6, U2.8 (A7)
unnamed: RN2.5, U2.9 (A8)
unnamed: RN3.8, U3.2 (A1)
unnamed: RN3.7, U3.3 (A2)
unnamed: RN3.6, U3.4 (A3)
unnamed: RN3.5, U3.5 (A4)
unnamed: RN4.8, U3.6 (A5)
U3_OE_N: U3.19 (/OE); also elsewhere on the board

Notes on the sheet:
ProFile bus. U2 carries the eight data lines both ways (DIR and /OE from the FPGA). U3 brings the five host-driven control lines in (pin 7, AUX7, is N/C and unused). /PBSY, /PPARITY and PCHK are driven by the FPGA through 220 R. All ProFile-side nets are 5 V.
U1 unit C: ProFile bus pins
U2: A = FPGA side (3.3 V), B = ProFile side (5 V). R4/R5 hold it disabled and pointed at the FPGA until the bitstream loads.
U3: B to A only (DIR = 0); /OE on U3_OE_N (R53 holds it off until the gateware drives U1 pin 76 low); unused B6 to B8 grounded.
ProFile port
J2 pin numbers are the ProFile cable's; the drive is the socket end. R14 keeps PH0 low with no cable attached. Pin 7 is N/C on the ProFile and the //e card, so it is not used: U3 B6 is grounded and U1 pin 104 (the C/D partner of PRES_N's pin 102) is open.
RN1 to RN4: 47R in series at the 74LVC245A A outputs, for source termination. Simulated 2026-10-09: without them the fast corner rings back into the threshold band on the long strobe lines.
R49 to R52: U3's host-side inputs (PCMD_N, PSTRB_N, PRW, PRES_N) idle high with no cable or the host off. TI requires a 74LVC245A's inputs held at a rail (PH0 has R14 to GND; B6 to B8 are grounded).
U3 is held off (OE high, R53) until the gateware drives U3_OE_N low after configuration: U1 pins 97/99 are an ECP5 A/B pair. The pair must not be driven apart before the core supply passes POR (Lattice FPGA-DS-02012 3.6). The host can hold them apart.

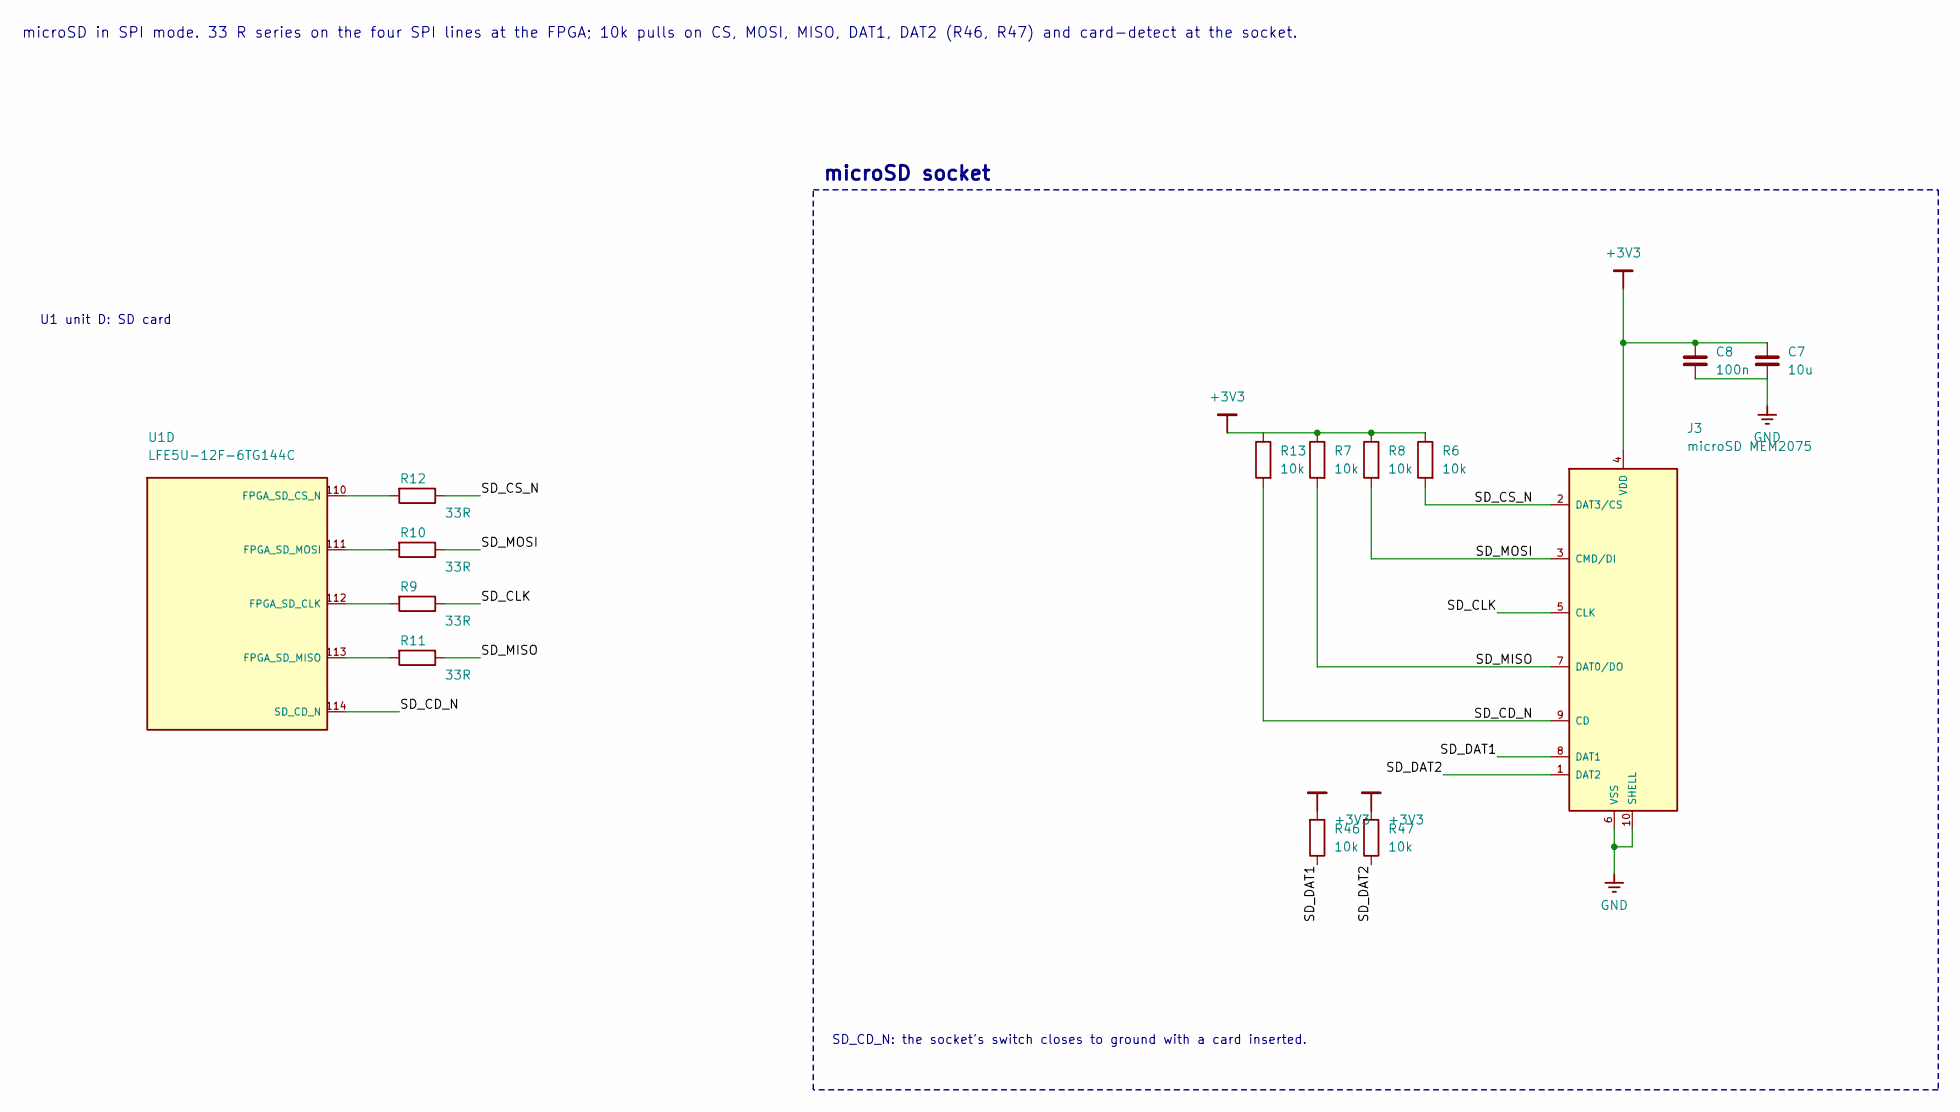
[picture p14: schematic sdcard.kicad_sch, SD card]

Parts:
C7: 10u; C_0603_1608Metric; MPN Murata GRM188R61E106MA73D; LCSC C91606
C8: 100n; C_0603_1608Metric; MPN Samsung CL10B104KO8NNNC; LCSC C66501
J3: microSD MEM2075; microSD_GCT_MEM2075; MPN GCT MEM2075-00-140-01-A; LCSC C3029735
R6, R7, R8, R13, R46, R47: 10k; R_0603_1608Metric; MPN Yageo RC0603FR-0710KL; LCSC C98220
R9, R10, R11, R12: 33R; R_0603_1608Metric; MPN Yageo RC0603FR-0733RL; LCSC C108661
U1: LFE5U-12F-6TG144C; TQFP-144_20x20mm_P0.5mm; MPN Lattice LFE5U-12F-6TG144C; LCSC C19979181

Connections:
/SD card/SD_CD_N: J3.9 (CD), R13.1, U1.114 (SD_CD_N)
/SD card/SD_CLK: J3.5 (CLK), R9.2
/SD card/SD_CS_N: J3.2 (DAT3/CS), R6.1, R12.2
/SD card/SD_DAT1: J3.8 (DAT1), R46.2
/SD card/SD_DAT2: J3.1 (DAT2), R47.2
/SD card/SD_MISO: J3.7 (DAT0/DO), R7.1, R11.2
/SD card/SD_MOSI: J3.3 (CMD/DI), R8.1, R10.2
unnamed: R9.1, U1.112 (FPGA_SD_CLK)
unnamed: R12.1, U1.110 (FPGA_SD_CS_N)
unnamed: R11.1, U1.113 (FPGA_SD_MISO)
unnamed: R10.1, U1.111 (FPGA_SD_MOSI)

Notes on the sheet:
microSD in SPI mode. 33 R series on the four SPI lines at the FPGA; 10k pulls on CS, MOSI, MISO, DAT1, DAT2 (R46, R47) and card-detect at the socket.
U1 unit D: SD card
microSD socket
SD_CD_N: the socket's switch closes to ground with a card inserted.
