JorjBauer/profile-emulator/fpga/hw-r2/profile-drive/profile-drive.kicad_pcb

## KiCad design fpga/hw-r2/profile-drive/profile-drive.kicad_pcb (continued)

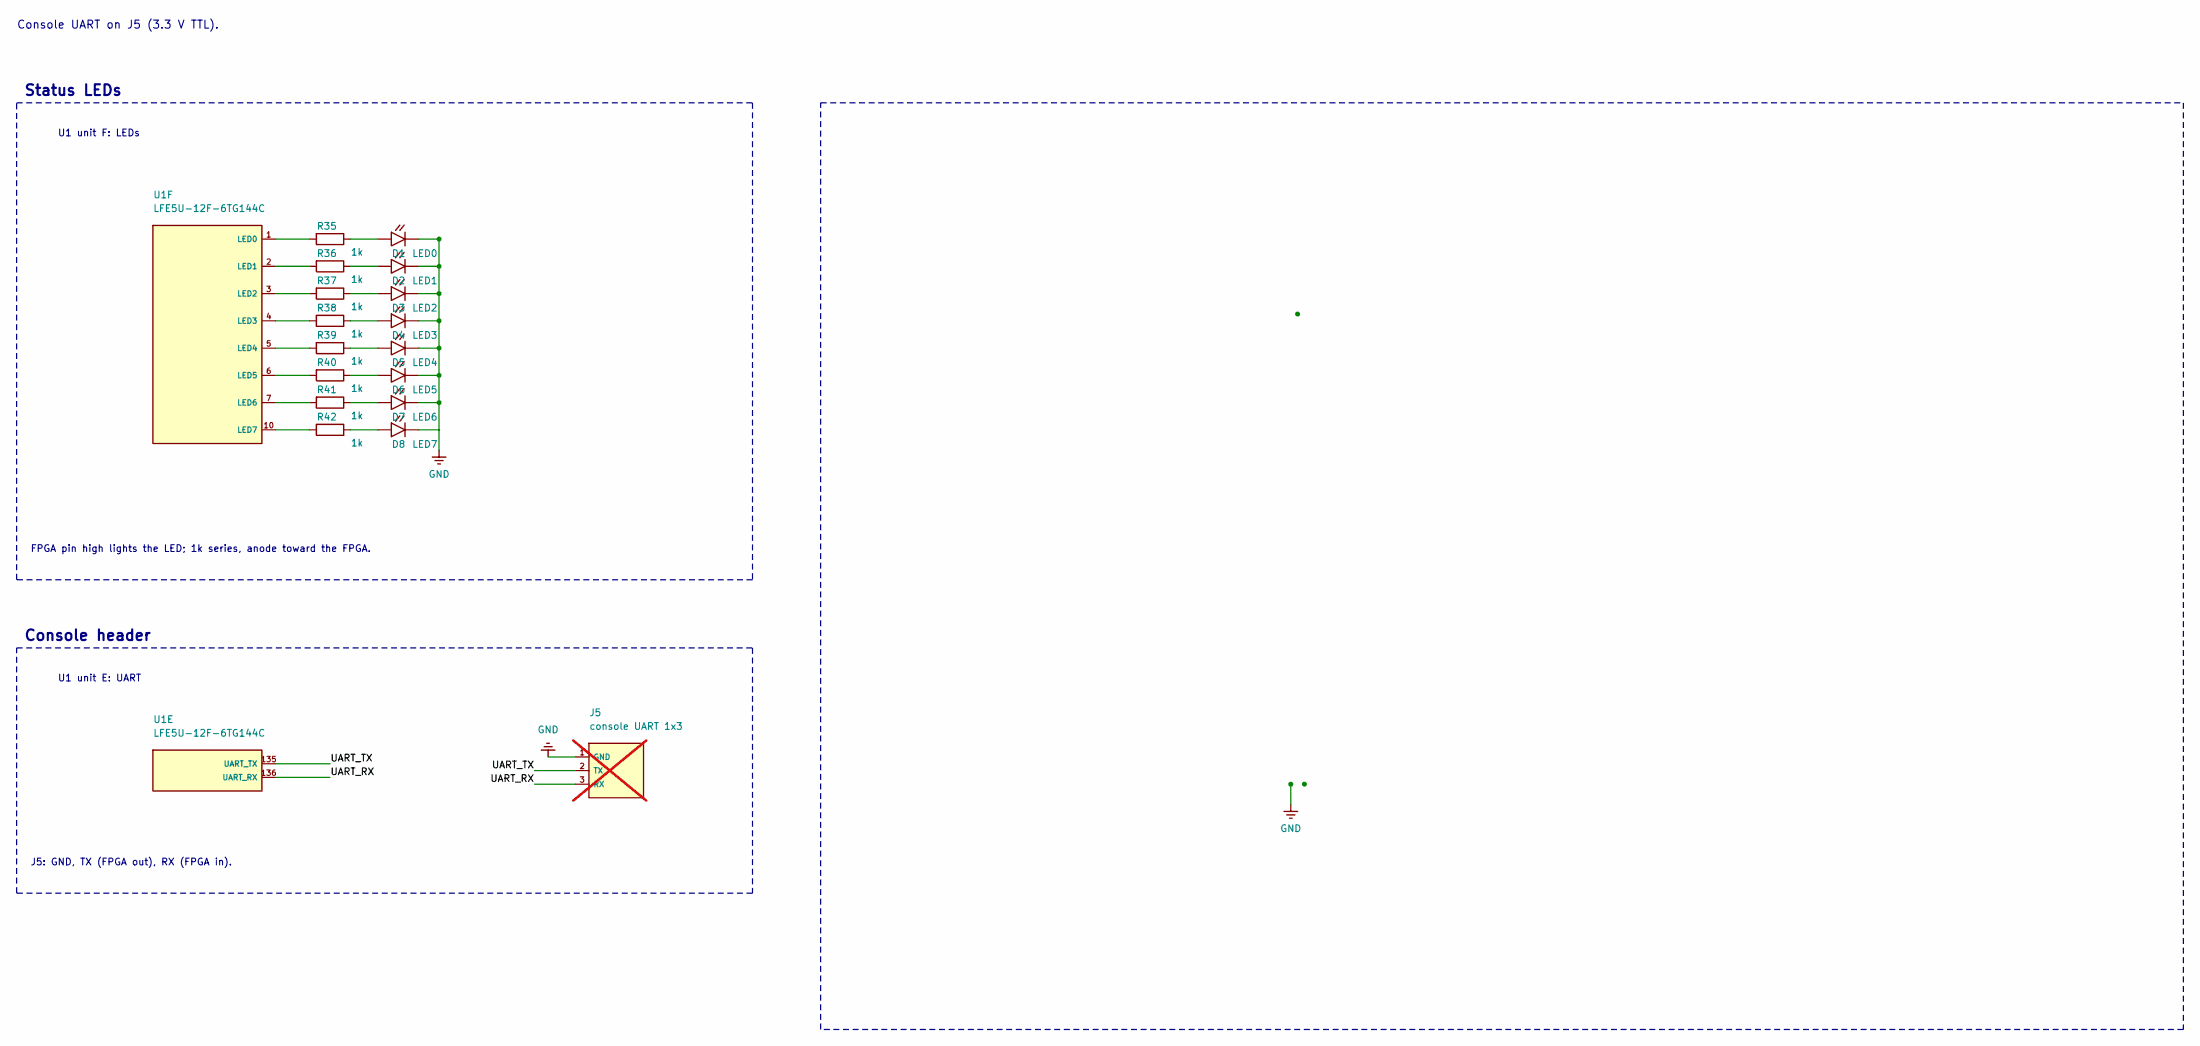
[picture p15: schematic uart_leds.kicad_sch, UART and LEDs]

Parts:
D1: LED0; LED_0603_1608Metric; LCSC C2286
D2: LED1; LED_0603_1608Metric; LCSC C2286
D3: LED2; LED_0603_1608Metric; LCSC C2286
D4: LED3; LED_0603_1608Metric; LCSC C2286
D5: LED4; LED_0603_1608Metric; LCSC C2286
D6: LED5; LED_0603_1608Metric; LCSC C2286
D7: LED6; LED_0603_1608Metric; LCSC C2286
D8: LED7; LED_0603_1608Metric; LCSC C2286
J5: console UART 1x3; PinHeader_1x03_P2.54mm_Vertical; not fitted
R35, R36, R37, R38, R39, R40, R41, R42: 1k; R_0603_1608Metric; MPN Yageo RC0603FR-071KL; LCSC C22548
U1: LFE5U-12F-6TG144C; TQFP-144_20x20mm_P0.5mm; MPN Lattice LFE5U-12F-6TG144C; LCSC C19979181

Connections:
/UART and LEDs/UART_RX: J5.3 (RX), U1.136 (UART_RX)
/UART and LEDs/UART_TX: J5.2 (TX), U1.135 (UART_TX)
unnamed: D1.2 (A), R35.2
unnamed: D2.2 (A), R36.2
unnamed: D3.2 (A), R37.2
unnamed: D4.2 (A), R38.2
unnamed: D5.2 (A), R39.2
unnamed: D6.2 (A), R40.2
unnamed: D7.2 (A), R41.2
unnamed: D8.2 (A), R42.2
unnamed: R35.1, U1.1 (LED0)
unnamed: R36.1, U1.2 (LED1)
unnamed: R37.1, U1.3 (LED2)
unnamed: R38.1, U1.4 (LED3)
unnamed: R39.1, U1.5 (LED4)
unnamed: R40.1, U1.6 (LED5)
unnamed: R41.1, U1.7 (LED6)
unnamed: R42.1, U1.10 (LED7)

Notes on the sheet:
Console UART on J5 (3.3 V TTL).
Status LEDs
U1 unit F: LEDs
FPGA pin high lights the LED; 1k series, anode toward the FPGA.
Console header
U1 unit E: UART
J5: GND, TX (FPGA out), RX (FPGA in).

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
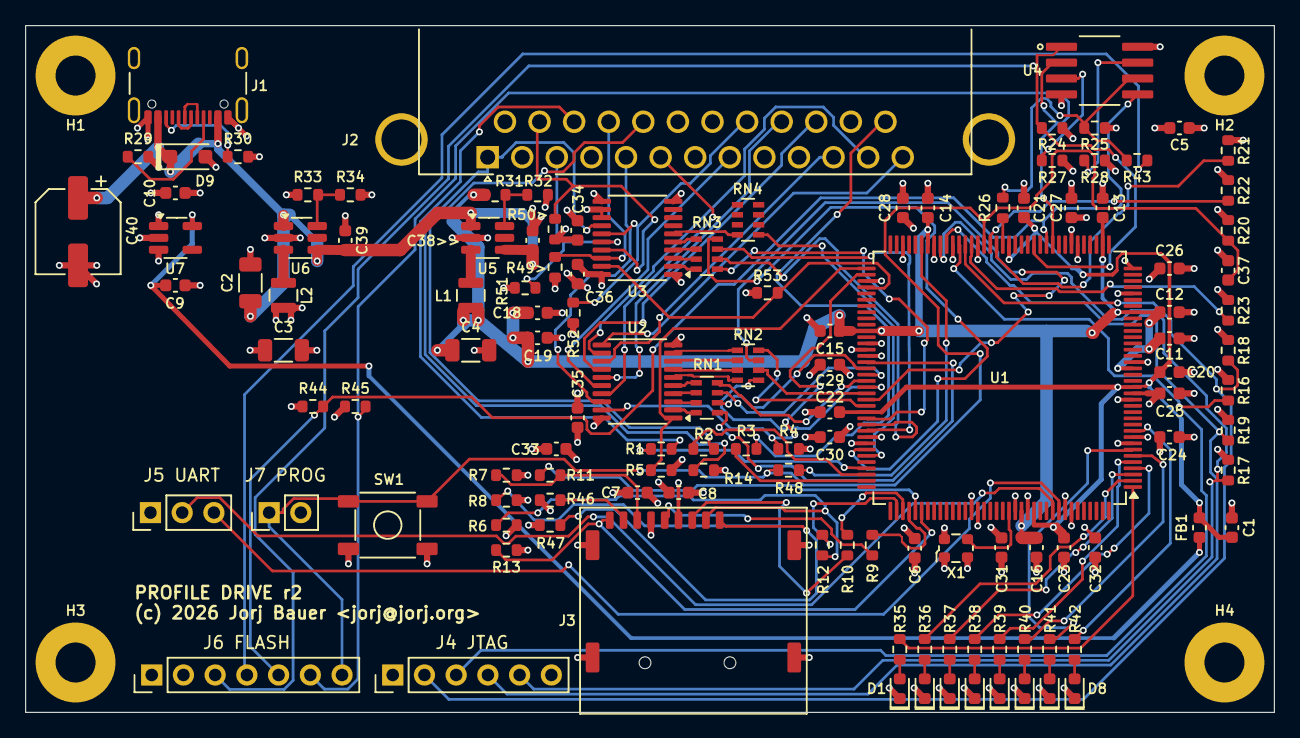
[picture p16: board profile-drive.kicad_pcb from above]

Board: 4 copper layers, 100.0 x 55.0 mm, 127 parts (0 on the bottom side), 109 nets.

Other parts of the board:
H1, H2, H3, H4: M3; MountingHole_3.2mm_M3_Pad
