JorjBauer/profile-emulator/fpga/src/reporter.v

// reporter: report what happened, over the UART.
//
// The board has no other output channel: eight LEDs, and until the
// DB-25 is connected, no host.
//
// WHY THIS IS ALL HEX AND NOT LABELED TEXT. A readable status line
// ("rdy=1 ok=1 err=0 ...") is a wide character mux over registers
// scattered across the die. It is large and sits on the critical
// path. Every field it names keeps that register alive upstream. So
// the values are packed into a 256-bit bundle, loaded into a shift
// register once, and clocked out as hex digits: one register load
// instead of a mux per column. The field layouts and their labels
// are documented in ../README.md.
//
// It repeats on a timer rather than firing once, so a terminal
// attached after power-up still sees it.

`default_nettype none

module reporter #(
                  parameter integer CLK_HZ = 50_000_000,
                  // The 512-byte hex dump of the block buffer. Useful
                  // on a bare bench, wasted logic once the card is
                  // known good.
                  parameter         DUMP = 1'b1
                  ) (
                     input  wire        clk,
                     input  wire        rst,
                     input  wire        go,             // self-test finished
                     input  wire        sd_ready,
                     input  wire        sd_ok,
                     input  wire [3:0]  err_code,
                     input  wire [4:0]  dbg_state,
                     input  wire [5:0]  dbg_cmd,
                     input  wire [255:0] dbg_fat,
                     input  wire [255:0] dbg_txn,
                     input  wire [7:0]  dbg_fst,
                     input  wire [7:0]  dbg_retries,
                     // Identifies the RUNNING bitstream: minutes
                     // since 2026-01-01 UTC, injected at synthesis. It is
                     // reported on every SD line so a test round can
                     // confirm which build is actually running before
                     // trusting anything else it says.
                     input  wire [31:0] build_id,
                     input  wire [63:0] fs_cfg,       // first 8 bytes of profile.cfg as read
                     input  wire [7:0]  fs_plen,      // {have_cfg, parsed path length}
                     input  wire [31:0] fs_c1,        // chain[1] as walked
                     input  wire [31:0] fs_c2,        // chain[2] as walked
                     input  wire [31:0] fs_fatstart,  // fat32's OWN fat_start, not the self-test's
                     input  wire [31:0] fs_nclus,

                     output reg  [9:0]  rd_addr,        // read address into the block buffer
                     input  wire [7:0]  rd_data,
                     output wire        active,

                     output wire        tx
                     );

   localparam integer PERIOD = CLK_HZ * 3 / 2;  // repeat every 1.5 s

   reg [7:0]          ch;
   reg                ch_stb;
   wire               busy;
   uart_tx #(.CLK_HZ(CLK_HZ)) u_tx (
                                    .clk(clk), .rst(rst), .data(ch), .stb(ch_stb), .busy(busy), .tx(tx));

   function [7:0] hex(input [3:0] n);
      hex = (n < 4'd10) ? (8'h30 + n) : (8'h41 + n - 4'd10);
   endfunction
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
