JorjBauer/profile-emulator/(commit log)

2026-09-05 schematic, first pass
2026-10-10 more fixes, and r2 gerber first pass
2026-10-10 proposed enclosure
2026-10-11 finally passing; added case too
2026-10-11 adding gerbers
2026-10-15 alternate stencil: smaller openings for the fine-pitched leads that I'm finding bridged with slumped solder paste
2026-10-24 cleaning up: adding BoM for builds, part numbers, DNP flags, etc.
2026-10-24 silkscreen WIP
