JorjBauer/profile-emulator/(notices)

Notices in the files:
fpga/hw-r2/profile-drive/profile-drive.kicad_pcb:
(c) 2026 Jorj Bauer
